guaiacol03/sirius_strobePlatform/fgpa_hub75/src/gowin_sdp/gowin_sdp.v

//Copyright (C)2014-2025 Gowin Semiconductor Corporation.
//All rights reserved.
//File Title: IP file
//Tool Version: V1.9.12.01 (64-bit)
//IP Version: 1.0
//Part Number: GW5A-LV25MG121NC1/I0
//Device: GW5A-25
//Device Version: A
//Created Time: Tue Jan  6 04:53:34 2026

module Gowin_SDP (dout, clka, cea, clkb, ceb, oce, reset, ada, din, adb);

output [63:0] dout;
input clka;
input cea;
input clkb;
input ceb;
input oce;
input reset;
input [7:0] ada;
input [63:0] din;
input [7:0] adb;

wire gw_vcc;
wire gw_gnd;

assign gw_vcc = 1'b1;
assign gw_gnd = 1'b0;

SDPB sdpb_inst_0 (
    .DO(dout[31:0]),
    .CLKA(clka),
    .CEA(cea),
    .CLKB(clkb),
    .CEB(ceb),
    .OCE(oce),
    .RESET(reset),
    .BLKSELA({gw_gnd,gw_gnd,gw_gnd}),
    .BLKSELB({gw_gnd,gw_gnd,gw_gnd}),
    .ADA({gw_gnd,ada[7:0],gw_gnd,gw_vcc,gw_vcc,gw_vcc,gw_vcc}),
    .DI(din[31:0]),
    .ADB({gw_gnd,adb[7:0],gw_gnd,gw_gnd,gw_gnd,gw_gnd,gw_gnd})
);

defparam sdpb_inst_0.READ_MODE = 1'b0;
defparam sdpb_inst_0.BIT_WIDTH_0 = 32;
defparam sdpb_inst_0.BIT_WIDTH_1 = 32;
defparam sdpb_inst_0.BLK_SEL_0 = 3'b000;
defparam sdpb_inst_0.BLK_SEL_1 = 3'b000;
defparam sdpb_inst_0.RESET_MODE = "SYNC";

SDPB sdpb_inst_1 (
    .DO(dout[63:32]),
    .CLKA(clka),
    .CEA(cea),
    .CLKB(clkb),
    .CEB(ceb),
    .OCE(oce),
    .RESET(reset),
    .BLKSELA({gw_gnd,gw_gnd,gw_gnd}),
    .BLKSELB({gw_gnd,gw_gnd,gw_gnd}),
    .ADA({gw_gnd,ada[7:0],gw_gnd,gw_vcc,gw_vcc,gw_vcc,gw_vcc}),
    .DI(din[63:32]),
    .ADB({gw_gnd,adb[7:0],gw_gnd,gw_gnd,gw_gnd,gw_gnd,gw_gnd})
);

defparam sdpb_inst_1.READ_MODE = 1'b0;
defparam sdpb_inst_1.BIT_WIDTH_0 = 32;
defparam sdpb_inst_1.BIT_WIDTH_1 = 32;
defparam sdpb_inst_1.BLK_SEL_0 = 3'b000;
defparam sdpb_inst_1.BLK_SEL_1 = 3'b000;
defparam sdpb_inst_1.RESET_MODE = "SYNC";

endmodule //Gowin_SDP
