guaiacol03/sirius_strobePlatform/(commit log)

2026-01-23 added encoder to fgpa
2026-01-26 changed prog to accomodate FPGA encoder
